Th1aG01/tcc_herege/Codigos/TCC_Bancada_v0_4/README.md

# Atualização v0.4.0

Leia primeiro docs/JSON_v04.md: payload JSON e botão Apagar TODOS na janela Arquivos no ESP32. Atualize o firmware e o aplicativo.

# TCC — Bancada de empuxo v0.4.0

**Testar por USB; depois enviar o registro completo por LoRa.**

Comece por **[LEIA_PRIMEIRO.md](LEIA_PRIMEIRO.md)**.

**v0.4.0:** cronômetro do ESP32 separado do horário da última amostra; causa de interrupção visível; duração efetiva registrada no JSON. Para investigar testes que terminam antes de 30 s, veja **[tempo_v0_3_1.md](docs/tempo_v0_3_1.md)**. Atualize firmware e aplicativo juntos.

| Onde executar | Arquivo | Função |
|---|---|---|
| Em cada computador que usará o aplicativo | `PREPARAR.bat` | Instalar dependências Python, uma vez |
| Computador conectado à bancada | `INICIAR.bat` | Controlar, visualizar e salvar o teste por USB |
| Notebook conectado ao receptor | `RECEPTOR_LORA.bat` | Receber o registro, salvar CSV e mostrar a curva |
| Opcional, sem hardware | `SIMULACAO.bat` | Simulador anterior |

Grave `firmware/Bancada_TCC_v0_3_1/Bancada_TCC_v0_3_1.ino` somente no ESP32 da bancada. O receptor BRAVO foi preservado.

Célula de teste de 5 kg **sem calibração**. Leituras reais em contagens. Não comanda ignição ou atuadores.

O envio posterior requer cópia interna do ensaio no ESP32. A confirmação de recebimento aparece no notebook receptor, após verificar o arquivo inteiro.
