Th1aG01/tcc_herege/Codigos/TCC_Bancada_v0_2/README.md

# TCC — Bancada de empuxo v0.2.0

Comece por **[LEIA_PRIMEIRO.md](LEIA_PRIMEIRO.md)**.

- `INICIAR.bat`: aquisição real por USB e estação LoRa BRAVO.
- `PREPARAR.bat`: prepara as dependências do aplicativo no Windows.
- `SIMULACAO.bat`: abre o simulador anterior, sem conexão ao hardware.
- `firmware/Bancada_TCC_v0_2/Bancada_TCC_v0_2.ino`: programa da bancada com seus pinos.
- `firmware/LoRaReceiver_BRAVO/LoRaReceiver_BRAVO.ino`: receptor original fornecido, sem alterações.
- `docs/protocolo_v0_2.md`: formato dos dados e comportamento das falhas.
- `docs/validacao.md`: verificações executadas e limites desta entrega.

**Célula de teste: 5 kg, não calibrada. A aquisição real não apresenta kg nem N.**

Esta pasta substitui a versão de demonstração como aplicativo principal; o modo de simulação e seus testes permanecem disponíveis separadamente.
