Th1aG01/tcc_herege/PCB/BottomLayer_PCB_TCC_Bateria.png

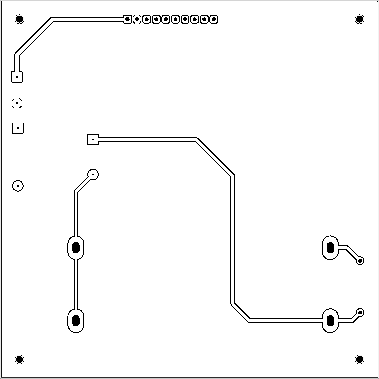
PCB/BottomLayer_PCB_TCC_Bateria.png
