Th1aG01/tcc_herege/PCB/BottomLayer_PCB_TCC_ESP.png

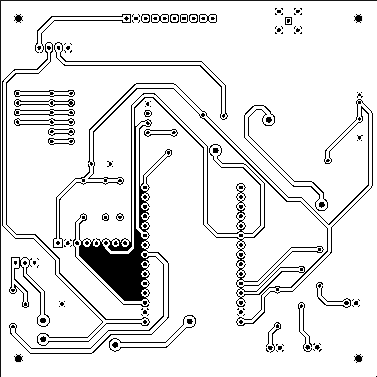
PCB/BottomLayer_PCB_TCC_ESP.png
