Th1aG01/tcc_herege/PCB/Toplayer_PCB_TCC_ESP.png

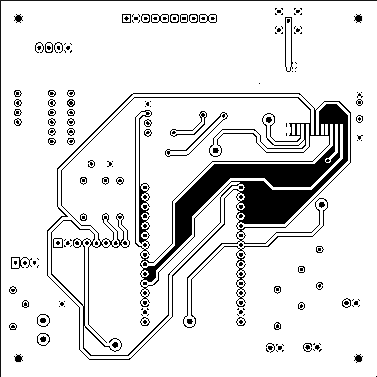
PCB/Toplayer_PCB_TCC_ESP.png
