Th1aG01/tcc_herege/(list of files, drawings)

Other design files:
PCB/PCB_TCC.json
PCB/PCB_TCC_Bateria.json
PCB/PCB_TCC_ESP.json
