Th1aG01/tcc_herege/Codigos/TCC_Bancada_v0_4/firmware/LoRaReceiver_BRAVO/LoRaReceiver_BRAVO.ino

#include <SPI.h>
#include <LoRa.h>

#define ss 5
#define rst 14
#define dio0 15
#define BAND 915E6

void setup() {
  Serial.begin(115200);
  while (!Serial);

  Serial.println("LoRa Receiver");

  LoRa.setPins(ss, rst, dio0);

  if (!LoRa.begin(BAND)) {
    Serial.println("Starting LoRa failed!");
    while (1);
  }

  LoRa.setSyncWord(145);
}

void loop() {
  // try to parse packet
  int packetSize = LoRa.parsePacket();
  if (packetSize) {
    // received a packet
    Serial.print("Received packet '");

    // read packet
    while (LoRa.available()) {
      Serial.print((char)LoRa.read());
    }

    // print RSSI of packet
    Serial.print("' with RSSI ");
    Serial.println(LoRa.packetRssi());
  }
}
