Th1aG01/tcc_herege/(commit log)

2026-10-15 Primeiro commit
    [PCB_TCC.json]
2026-10-19 PNG das PCB's
2026-10-20 PCB atualizado
    [PCB_TCC.json]
2026-11-09 Atualização codigo
    [amostras_SIMULADAS.csv]
2026-11-10 Atualização dos Codigos
    [amostras_SIMULADAS.csv]
